JeremySSSSS/tfg-pulpissimo/Documento TFG/titlepage.tex

\thispagestyle{empty}

\begin{center}

Tecnológico de Costa Rica

\par\vspace{1ex}

Escuela de Ingeniería Electrónica

\par\vspace{1ex}

Programa de Licenciatura en Ingeniería Electrónica

\par\vspace{20mm}



\par\vspace*{\fill}

{\large\bf{\scriptTitle}}

\par\vspace*{\fill}

\scriptType

\par\vspace{20mm}

\scriptAuthor

\par\vspace{2ex}

\genderAsesor: \nameAsesor

\par\vspace{2ex}

Campus Tecnológico Local San Carlos

\vspace*{\fill}

\ifdraft{{\today}}{San Carlos, Costa Rica, 2026}

\end{center}
\newpage
\cleardoublepage

%%% Local Variables:
%%% mode: latex
%%% TeX-master: "main"
%%% End:
