JeremySSSSS/tfg-pulpissimo/Documento TFG/acta.tex

%% Acta de Evaluación — remover en versión final

\thispagestyle{empty}

\begin{center}
  \begin{tabular}{c}
    Instituto Tecnológico de Costa Rica \\
    Escuela de Ingeniería Electrónica \\
    Trabajo Final de Graduación \\
    Tribunal Evaluador \\
    Acta de Evaluación
  \end{tabular}
\end{center}

\vfill

\begin{center}
  \begin{tabular}{c}
    Defensa de Proyecto de Graduación \\
    Requisito para optar por el título de Ingeniero en Electrónica \\
    Grado Académico de Licenciatura
  \end{tabular}
\end{center}

\vfill

\begin{center}
  Estudiante:\qquad \textbf{\scriptAuthor}\qquad Carné: \scriptAuthorID

  \vspace*{2ex}

  \setlength\tabcolsep{0pt}
  \begin{tabular}{p{.28\textwidth}p{.70\textwidth}}
    Nombre del proyecto: & \textsl{\scriptTitle}
  \end{tabular}
\end{center}

\vspace{5mm}

\vfill

Los miembros de este Tribunal hacen constar que este proyecto de
graduación ha sido aprobado y cumple con las normas establecidas por
la Escuela de Ingeniería Electrónica del Instituto Tecnológico de
Costa Rica y es merecedor de la siguiente calificación:

\vfill

\begin{center}
  Nota de Proyecto de Graduación: \rule{25mm}{0.5pt}
\end{center}

\vfill

\begin{center}
  Miembros del Tribunal Evaluador
\end{center}

\vfill

\begin{center}
  \begin{tabularx}{\textwidth}{cXc}
    \rule{0.45\textwidth}{0.5pt} && \rule{0.45\textwidth}{0.5pt} \\
    \nameLectorI                 && \nameLectorII \\
    \genderLectorI               && \genderLectorII
  \end{tabularx}

  \vspace{10mm}

  \begin{tabular}{c}
    \rule{0.45\textwidth}{0.5pt} \\
    \nameAsesor \\
    \genderAsesor
  \end{tabular}
\end{center}

\vfill

\begin{center}
  San Carlos, \today
\end{center}

\cleardoublepage

%%% Local Variables:
%%% mode: latex
%%% TeX-master: "main"
%%% End:
