JeremySSSSS/tfg-pulpissimo/Documento TFG/tribunal.tex

%% Acta de Aprobación — remover en versión final

\thispagestyle{empty}

\begin{center}
  \begin{tabular}{c}
    Instituto Tecnológico de Costa Rica \\
    Escuela de Ingeniería Electrónica \\
    Anteproyecto de Trabajo Final de Graduación \\
    Acta de Aprobación
  \end{tabular}
\end{center}

\vfill

\begin{center}
  \begin{tabular}{c}
    Defensa de Proyecto de Graduación \\
    Requisito para optar por el título de Ingeniero en Electrónica \\
    Grado Académico de Licenciatura
  \end{tabular}
\end{center}

\vfill

El Tribunal Evaluador aprueba la defensa del proyecto de graduación
denominado \textsl{\scriptTitle}, realizado por
el señor \scriptAuthor\ y, hace constar que cumple con las normas
establecidas por la Escuela de Ingeniería Electrónica del Instituto
Tecnológico de Costa Rica.

\vfill

\begin{center}
  Miembros del Tribunal Evaluador
\end{center}

\vfill

\begin{center}
  \begin{tabularx}{\textwidth}{cXc}
    \rule{0.45\textwidth}{0.5pt} && \rule{0.45\textwidth}{0.5pt} \\
    \nameLectorI                 && \nameLectorII \\
    \genderLectorI               && \genderLectorII
  \end{tabularx}

  \vspace{10mm}

  \begin{tabular}{c}
    \rule{0.45\textwidth}{0.5pt} \\
    \nameAsesor \\
    \genderAsesor
  \end{tabular}
\end{center}

\vfill

\begin{center}
  San Carlos, \today
\end{center}

\cleardoublepage

%%% Local Variables:
%%% mode: latex
%%% TeX-master: "main"
%%% End:
