JeremySSSSS/tfg-pulpissimo/Documento TFG/fig/schematic_ina240_ads1115.pdf

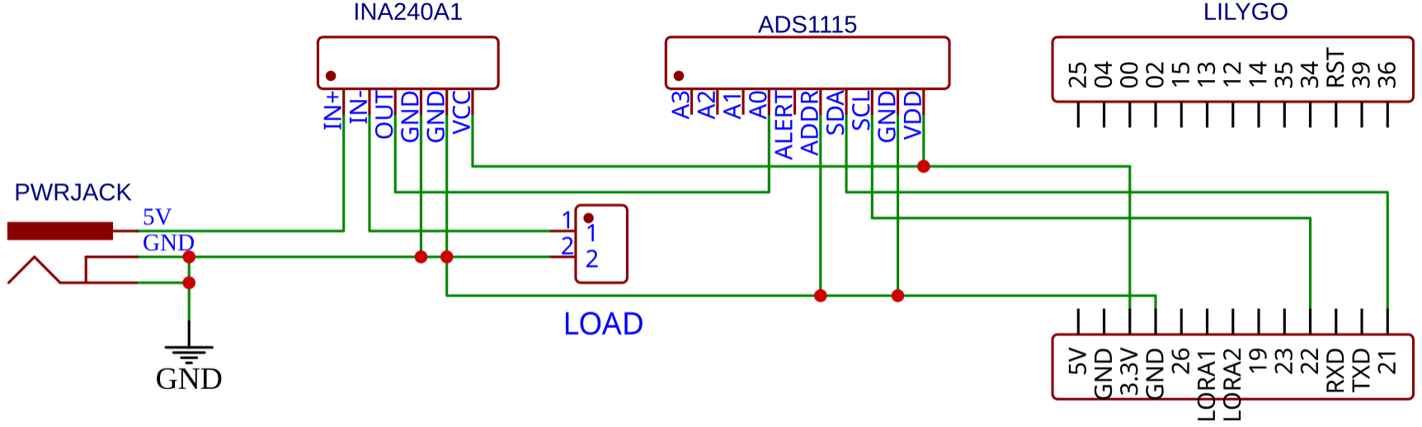
[picture p2: page 1]
