JeremySSSSS/tfg-pulpissimo/Documento TFG/fig/ina240_module.pdf

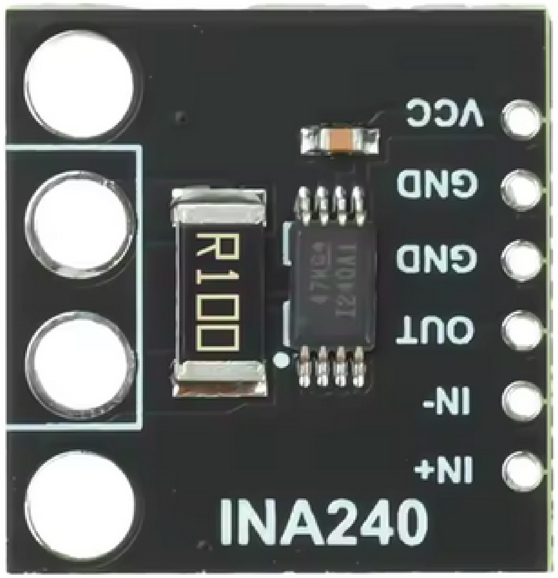
[picture p20: page 1]
