JeremySSSSS/tfg-pulpissimo/Documento TFG/fig/inamp_circuit.pdf

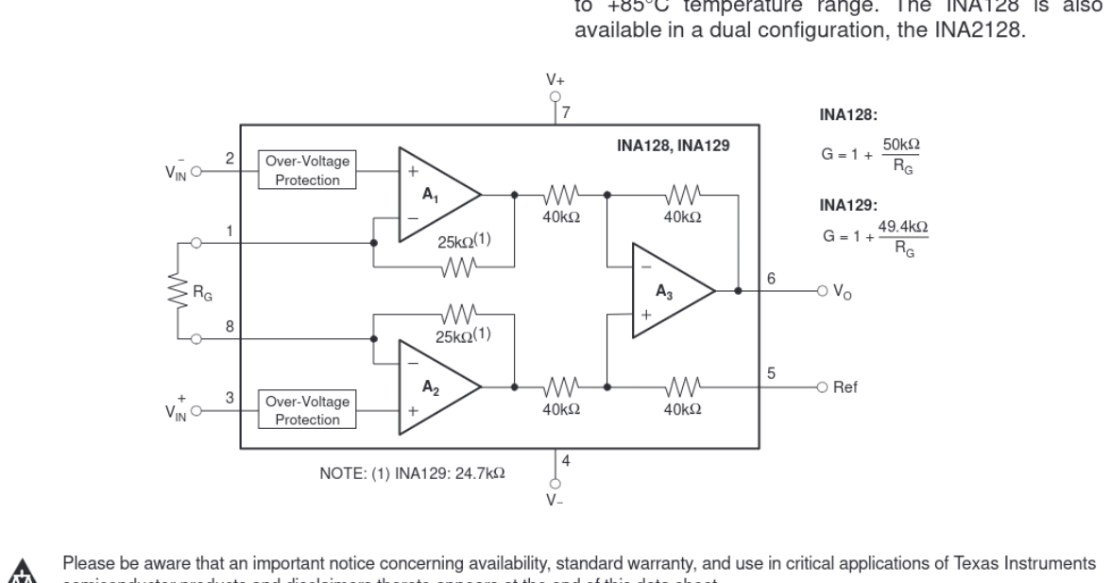
[picture p21: page 1]
