JeremySSSSS/tfg-pulpissimo/Documento TFG/fig/inamp_page1.pdf

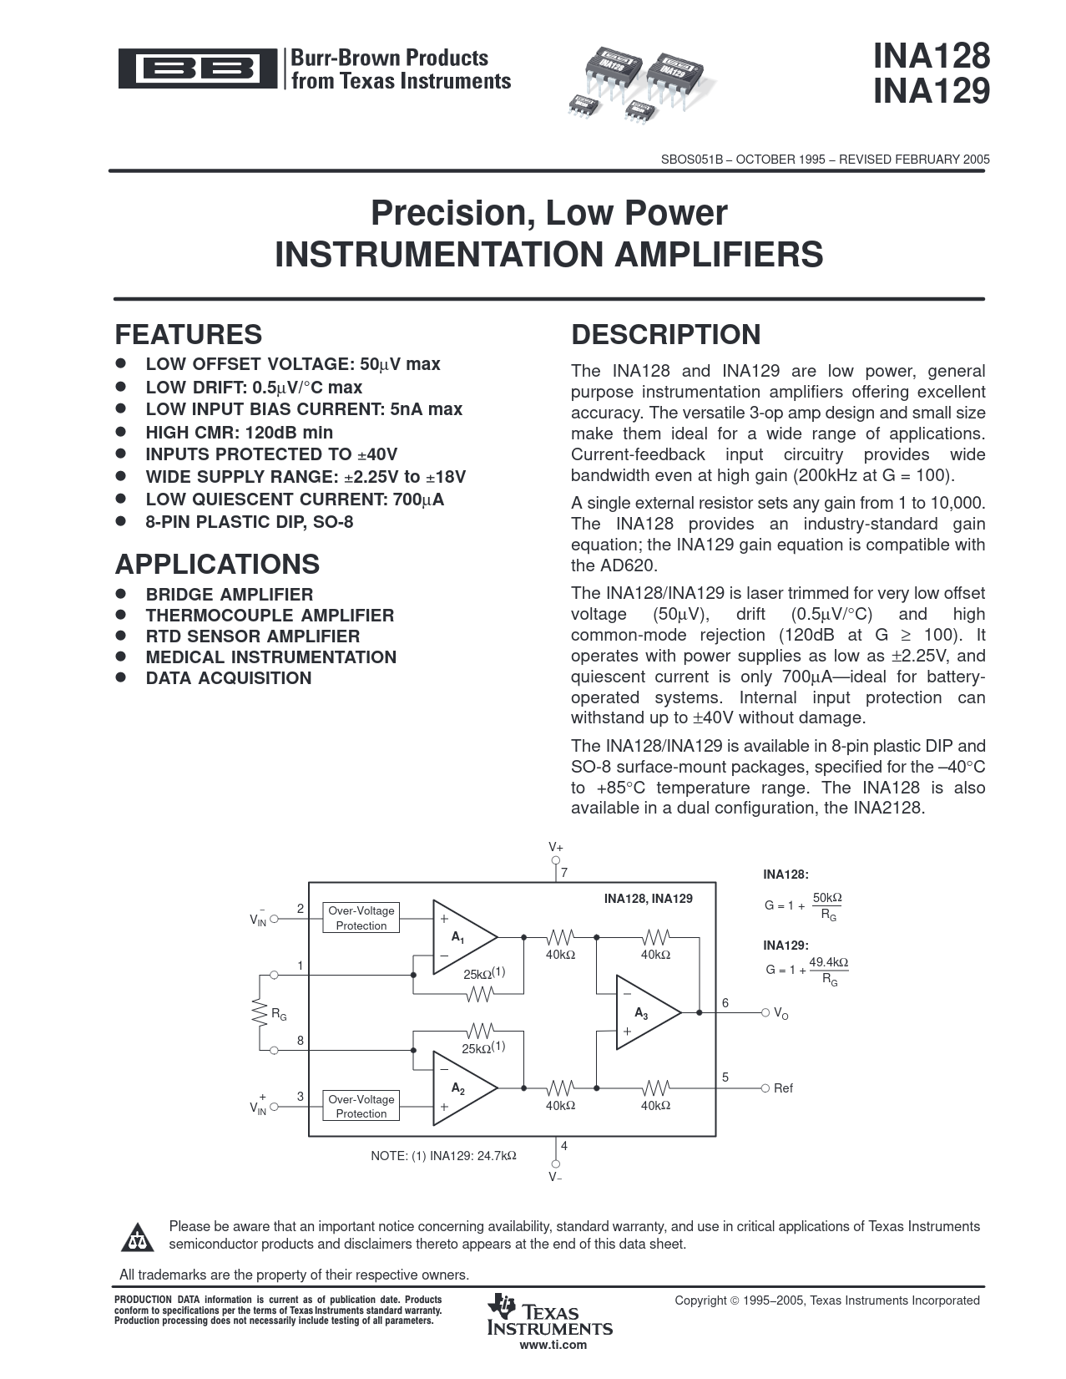
[picture p22: figure]
