JeremySSSSS/tfg-pulpissimo/Documento TFG/fig/ina240_typical_application.png

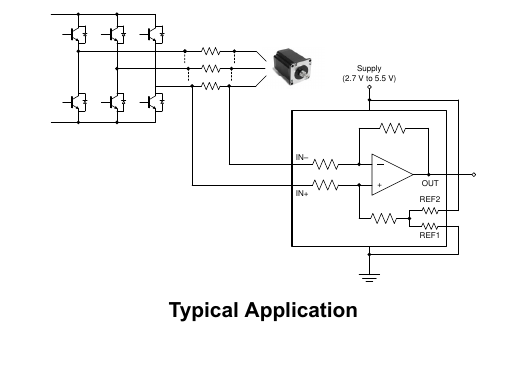
Documento TFG/fig/ina240_typical_application.png
