JeremySSSSS/tfg-pulpissimo/Documento TFG/fig/pcb_ina240_ads1115-1.png

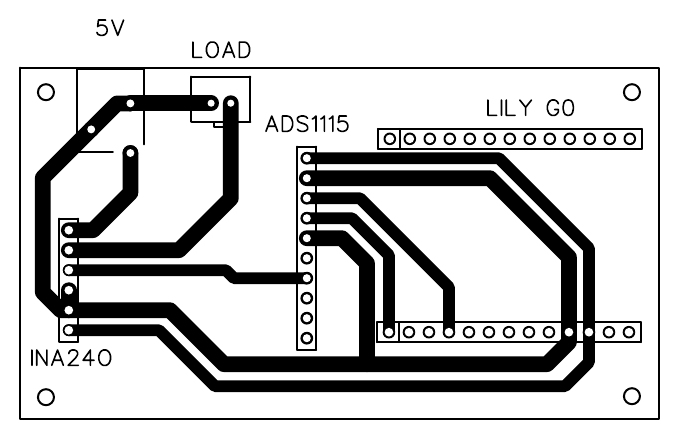
Documento TFG/fig/pcb_ina240_ads1115-1.png
