JeremySSSSS/tfg-pulpissimo/Documento TFG/fig/schematic_ina240_ads1115.png

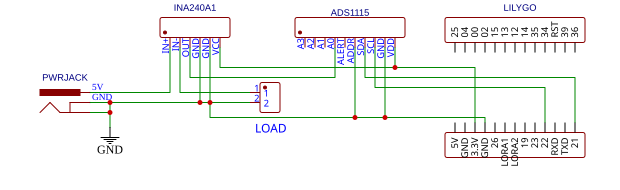
Documento TFG/fig/schematic_ina240_ads1115.png
