JeremySSSSS/tfg-pulpissimo/(list of files, cad)

Other CAD files:
pulpissimo/doc/datasheet/figures_raw/riscv_overview.obj
