JeremySSSSS/tfg-pulpissimo/cv32e40p/firmware/caracterizacion/verificacion.csv

fecha | metodo | programa | T_s | P_med_W | P_pred_W | err_pct | temp_C | n_alu | n_mul | n_mulh | n_div | c_div | n_mem | n_ctrl | n_float | mcycle
2026-07-12 09:25:35 | regresion | bitcount | 93.699 | 1.174457 | 1.174155 | -0.0257 | 40.47 | 517150016 | 0 | 0 | 0 | 0 | 5120004 | 133120001 | 0 | 936990023
2026-07-12 09:26:02 | regresion | bsearch | 12.111 | 1.167593 | 1.16961 | 0.1727 | 40.23 | 60622612 | 0 | 0 | 0 | 0 | 6694406 | 11625412 | 0 | 121113466
2026-07-12 09:31:23 | regresion | conv | 306.634 | 1.165568 | 1.16878 | 0.2756 | 40.72 | 1473186020 | 174592000 | 0 | 0 | 0 | 360096004 | 174592001 | 0 | 3066338027
2026-07-12 09:31:48 | regresion | fixmul | 11.745 | 1.164867 | 1.169049 | 0.359 | 40.6 | 29250017 | 14400000 | 14400000 | 0 | 0 | 4 | 450001 | 0 | 117450020
2026-07-12 09:32:33 | regresion | md5 | 32.088 | 1.169026 | 1.170362 | 0.1142 | 40.6 | 203880020 | 0 | 0 | 0 | 0 | 16320004 | 21120001 | 0 | 320880028
2026-07-12 09:32:54 | regresion | primes | 5.451 | 1.157364 | 1.157617 | 0.0219 | 40.6 | 5081833 | 1411260 | 0 | 1385460 | 42880200 | 4 | 1591141 | 0 | 54506480
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
