JeremySSSSS/tfg-pulpissimo/cv32e40p/firmware/caracterizacion/archivo/2026-07-12_pre_corrida_limpia/verificacion.csv

fecha | metodo | programa | T_s | P_med_W | P_pred_W | err_pct | n_alu | n_mul | n_mulh | n_div | c_div | n_mem | n_ctrl | n_float | mcycle
2026-06-18 16:45:09 | chopper | sha256 | 39.004 | 0.011575 | 9.251665 | 79827.9914 | 310380609 | 0 | 0 | 0 | 0 | 34650090 | 13370064 | 0 | 390040952
2026-06-18 16:45:54 | chopper | md5 | 30.696 | 0.012660 | 9.248301 | 72951.3480 | 170280175 | 5760000 | 0 | 0 | 0 | 23520044 | 36360016 | 0 | 306960285
2026-06-18 16:49:20 | chopper | sha256 | 39.004 | 0.005807 | 9.251665 | 159219.1838 | 310380609 | 0 | 0 | 0 | 0 | 34650090 | 13370064 | 0 | 390040952
2026-06-18 16:52:17 | chopper | sha256 | 39.004 | 5.087820 | 9.251665 | 81.8395 | 310380609 | 0 | 0 | 0 | 0 | 34650090 | 13370064 | 0 | 390040952
2026-06-18 16:55:08 | chopper | sha256 | 39.004 | 9.259173 | 9.251665 | -0.0811 | 310380609 | 0 | 0 | 0 | 0 | 34650090 | 13370064 | 0 | 390040952
2026-06-18 16:55:53 | chopper | md5 | 30.696 | 9.260119 | 9.248301 | -0.1276 | 170280175 | 5760000 | 0 | 0 | 0 | 23520044 | 36360016 | 0 | 306960285
2026-06-18 16:57:21 | chopper | floyd | 74.701 | 9.256475 | 9.244476 | -0.1296 | 220848909 | 800 | 0 | 980800 | 27463200 | 105686500 | 97335511 | 0 | 747006340
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
