JeremySSSSS/tfg-pulpissimo/Documento TFG/figuras/setup_medicion.pdf

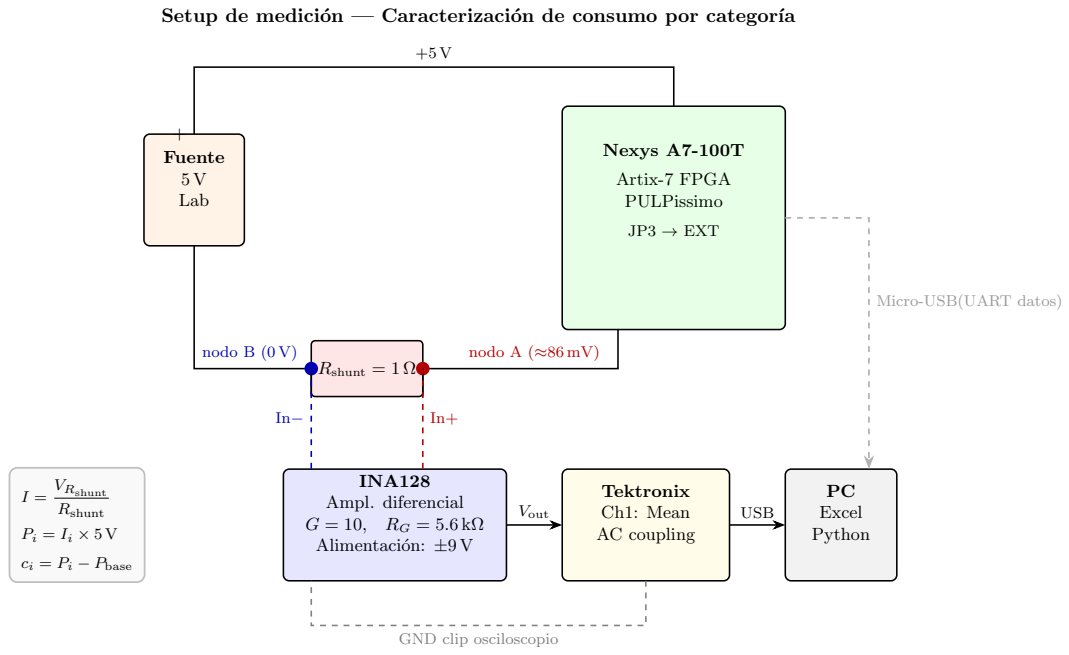
[picture p38: page 1]
Fuente 5 V Lab; Nexys A7-100T; Artix-7 FPGA PULPissimo; JP3 → EXT; Rshunt = 1 Ω; INA128 Ampl. diferencial G = 10, RG = 5.6 kΩ Alimentaci´on: ±9 V; Tektronix Ch1: Mean AC coupling; PC Excel Python; nodo B (0 V); nodo A (≈86 mV); Vout; USB; VRshunt; Rshunt

Setup de medici´on — Caracterizaci´on de consumo por categor´ıa

Micro-USB(UART datos)

ci = Pi − Pbase

GND clip osciloscopio
