JeremySSSSS/tfg-pulpissimo/Documento TFG/fig/diagrama_3_1_arquitectura_general.pdf

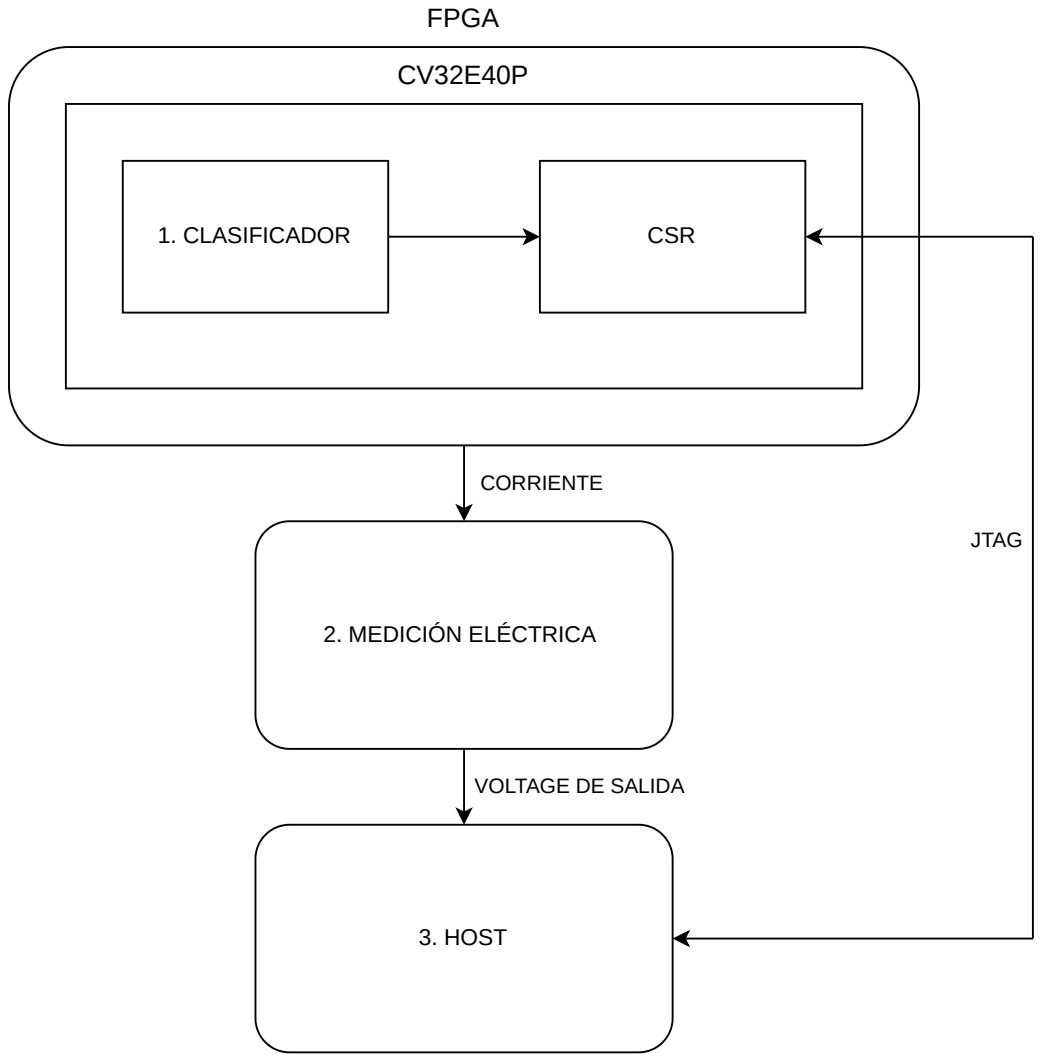
[picture p39: page 1]
CORRIENTE; 1. CLASIFICADOR; CSR; 2. MEDICIÓN ELÉCTRICA; 3. HOST; JTAG; FPGA

VOLTAGE DE SALIDA
