JeremySSSSS/tfg-pulpissimo/Documento TFG/fig/diagrama_3_3_shunt_alimentacion.pdf

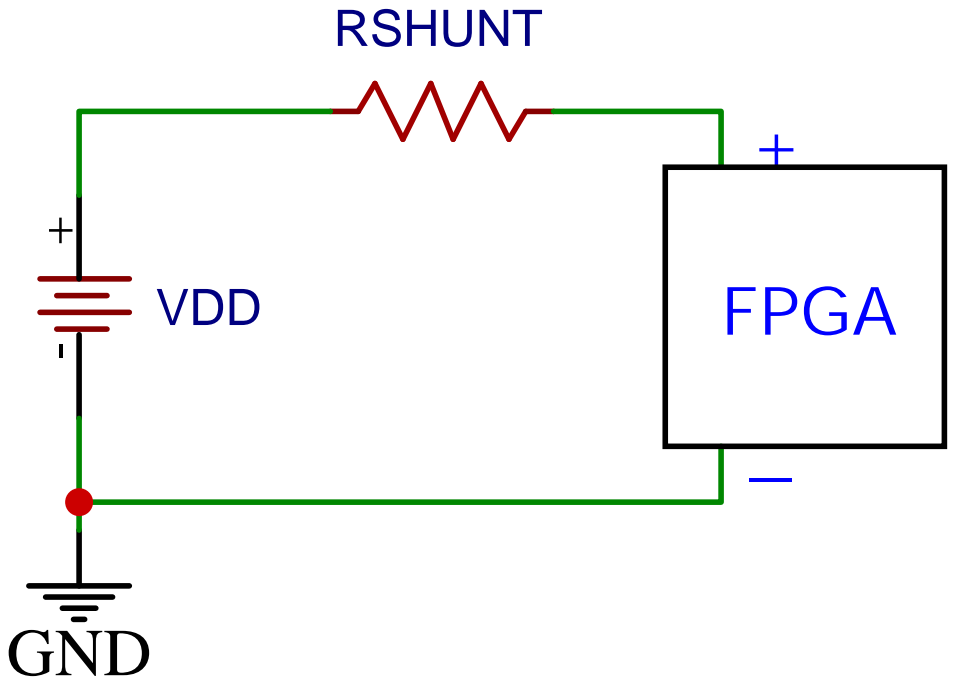
[picture p40: page 1]
