JeremySSSSS/tfg-pulpissimo/Documento TFG/fig/diagrama_3_4_cadena_adquisicion.pdf

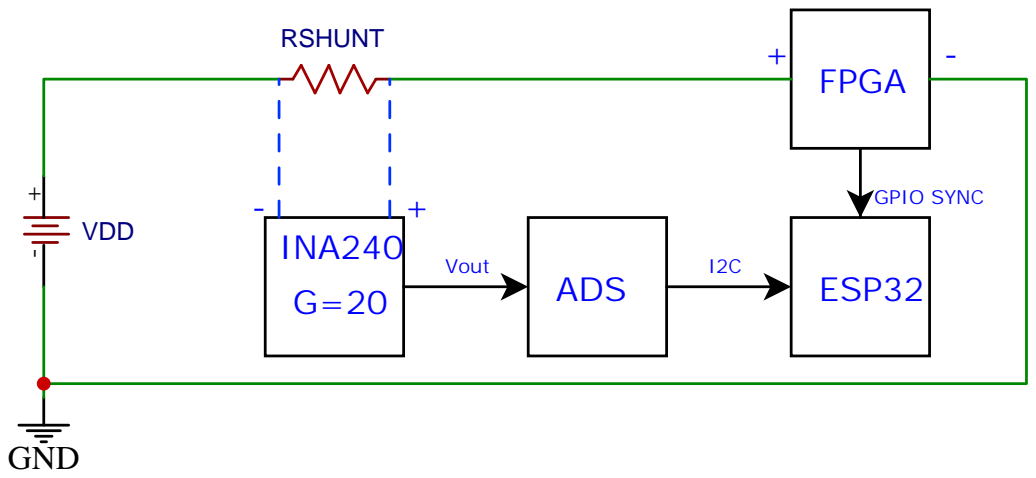
[picture p41: page 1]

A | A
B | B
C | C
D | D

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
TITLE:
Sheet_2 | REV: 1.0
Date: | 2026-06-06

Sheet: 1/1
Drawn By: jeremysotoch

Company: Your Company
