JeremySSSSS/tfg-pulpissimo/Documento TFG/fig/diagrama_3_5_integracion_clasificador.pdf

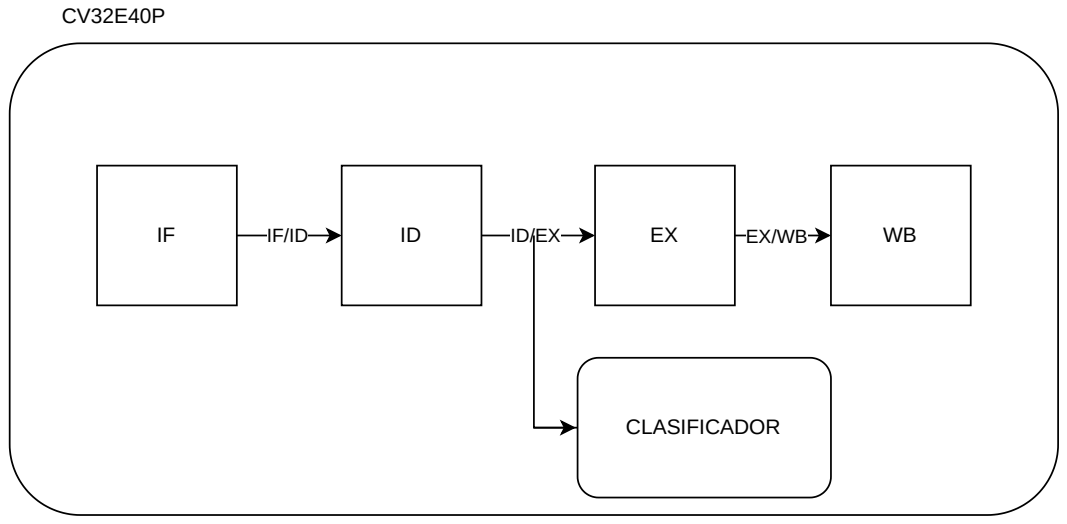
[picture p42: page 1]
CLASIFICADOR
