JeremySSSSS/tfg-pulpissimo/Documento TFG/fig/diagrama_3_6_cadena_jtag.pdf

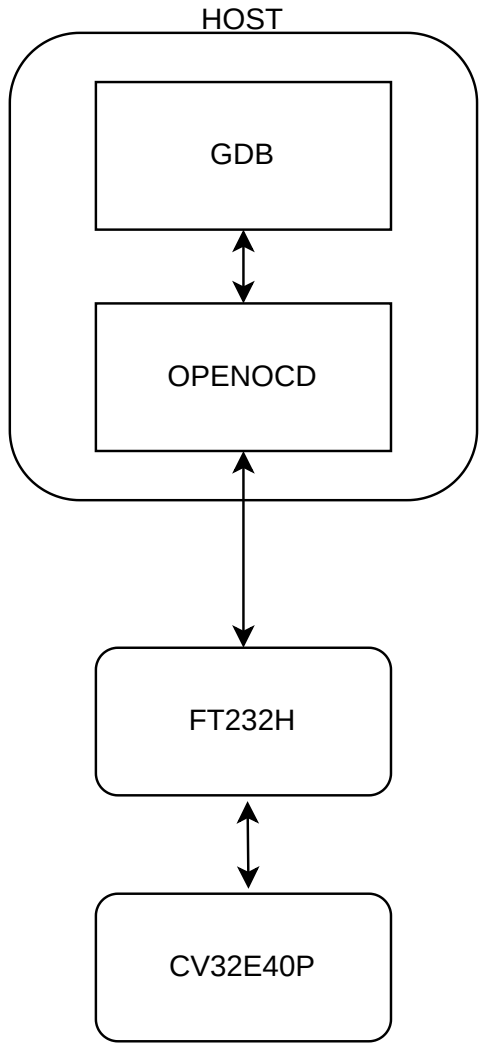
[picture p43: page 1]
GDB; OPENOCD; HOST
