JeremySSSSS/tfg-pulpissimo/Documento TFG/fig/pcb_ina240_ads1115.pdf

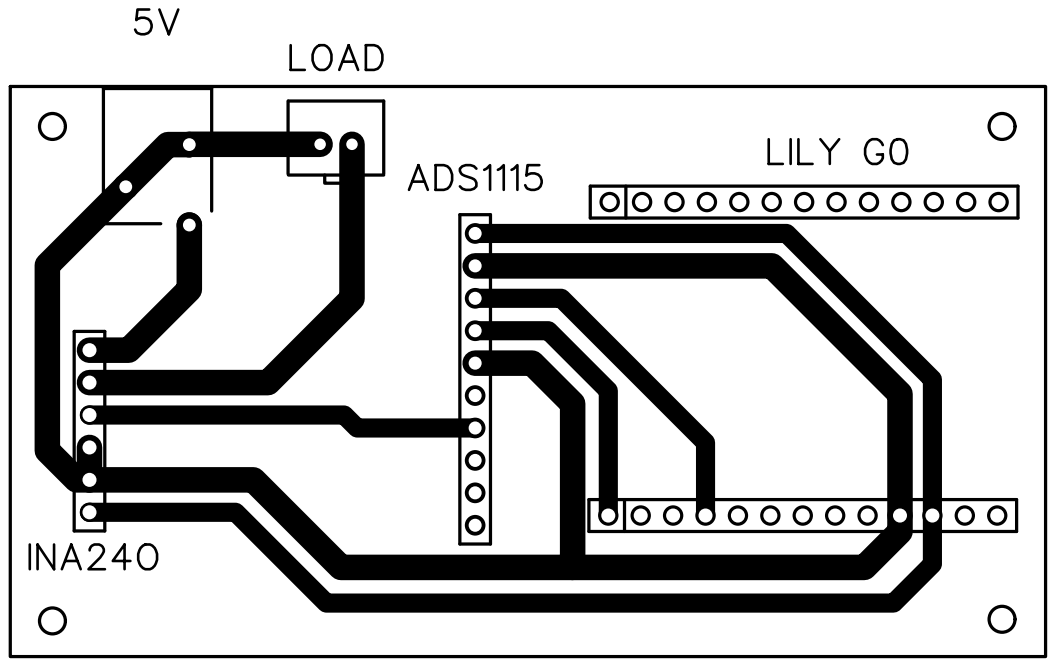
[picture p44: page 1]
