JeremySSSSS/tfg-pulpissimo/Documento TFG/fig/TEC.pdf

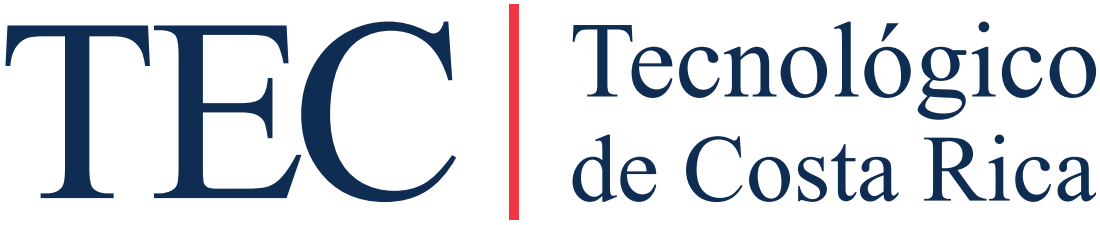
[picture p45: page 1]
