JeremySSSSS/tfg-pulpissimo/(list of files, drawings)

Other design files:
Circuito de Potencia/PCB_New-Project123-copy_2026-06-21.pcbdoc
