JeremySSSSS/tfg-pulpissimo/(commit log)

2026-06-12 Base: PULPissimo (pulp-platform/pulpissimo @ bfc3d9a) + CV32E40P (pulp-platform/cv32e40p @ 7a49867)
    Árbol upstream sin modificar de ambos proyectos como punto de partida del TFG.
    - pulpissimo/: SoC, targets FPGA (Nexys A7), flujo Bender/Vivado
    - cv32e40p/: core RISC-V RV32IMC, base del clasificador de instrucciones
    [riscv_overview.obj]
2026-06-12 cv32e40p: clasificador de instrucciones por categoría (CSR 0xBC0-0xBCB)
    Módulo cv32e40p_insn_classifier.sv: clasifica cada instrucción retirada en
    6 categorías (arith, logic, memory, branch, jump, float) con contadores de
    64 bits expuestos como 12 CSR custom en pares LO/HI (0xBC0-0xBCB).
    - cv32e40p_pkg.sv: direcciones de los 12 CSR
    - cv32e40p_core.sv: instancia del clasificador + mux de lectura CSR
    - cv32e40p_decoder.sv: acepta los CSR custom sin illegal instruction
    - Filtro csr_access para no contaminar el conteo con los propios csrr/csrw
    - Manifiestos (Bender.yml, flist, src_files.yml) actualizados
2026-06-12 pulpissimo: plataforma FPGA Nexys A7-100T para medición de consumo
    - xilinx_pulpissimo.v: puerto pad_esp32_sync (io_08, antes led0_o) como
    pulso de sincronización hacia la ESP32; fix pad_jtag_tdo input->inout
    (impedía el enganche de OpenOCD)
    - nexys4DDR.xdc: pad_esp32_sync -> H4 (PMOD JD1); constraints de
    temporización JTAG (create_clock TCK, clock groups asíncronos, max_delay
    en CDC del dmi_jtag)
    - openocd-ft232h.cfg: configuración OpenOCD para adaptador FT232H
    - run_batch.tcl: síntesis no incremental (fix Synth 8-6885), limpieza de
    pads no usados post-síntesis, BIN_FILE true
2026-06-12 cv32e40p: firmware de caracterización por categoría
    - firmware/dominated_loops/: bucles dominados (~97%) por categoría
    (arith, logic, memory, branch, jump, float), ventana de medición por
    GPIO8 -> GPIO26 (ESP32), fin con ebreak
    - frequency_probe.S: verificación de la frecuencia real del core (10 MHz)
    - csr_test/: test mínimo de los contadores vía JTAG/GDB (COMANDOS_JTAG.md)
2026-06-12 pulpissimo: bitstreams Nexys A7-100T
    - xilinx_pulpissimo_12csr.bit: bitstream actual con los 12 CSR del
    clasificador y el fix de JTAG TDO
    - xilinx_pulpissimo_jtagfix_20260604.bit: bitstream previo (fix JTAG TDO,
    2026-06-04), conservado como referencia
2026-06-12 Documentación de los cambios del TFG (CAMBIOS_TFG.md)
2026-06-12 Agrega README: descripción del proyecto y resumen de cambios
2026-06-12 Corrige clasificación del rango CSR 0xBC0-0xBCB: machine custom RW, no user
    Según la convención de direcciones del privileged spec RISC-V, en 0xBC0
    los bits [9:8]=11 indican nivel máquina y [11:10]=10 read/write.
2026-06-12 Agrega documento escrito del TFG (fuentes LaTeX + PDF compilado)
    - tfg_doc/: capítulos .tex, referencias.bib, figuras (fig/), estilos y
    main.pdf compilado (47 páginas); .gitignore para artefactos de LaTeX
    - DOCS/: diagramas CV32E40P y PULPissimo referenciados por marco_teo.tex
    vía ../DOCS/, de modo que el documento compila desde el repo
2026-06-12 Renombra tfg_doc/ a Anteproyecto/ y completa DOCS/ con el material de referencia
    - Anteproyecto/: mismo contenido (la ruta relativa ../DOCS/ sigue resolviendo)
    - DOCS/: datasheets, papers, esquemáticos y PCB del medidor high-side,
    manuales de referencia y figuras (88 archivos)
2026-06-12 Agrega Documento TFG/: plantilla del informe final (tesis)
    Derivada del anteproyecto con la estructura del informe final:
    - implementacion.tex: esqueleto con la sección nueva de categorías por
    firma de energía (esquema confirmado para la tesis) y TODOs por sección
    - resultados.tex: verificación funcional, caracterización M1/M2,
    validación contra la hipótesis del 10% y discusión
    - conclusiones.tex: conclusiones por OE y trabajo futuro
    - main.tex: scriptType de informe final; solucion/experimento/cronograma
    fuera del compilado como material de referencia
    - intro/resumen/objetivos con notas de conversión a voz ejecutada
2026-06-12 Agrega carpetas Circuito de Potencia/ y TTGO LORA32/ (vacías, con .gitkeep)
2026-06-12 README: agrega las carpetas nuevas a la tabla de estructura
2026-06-12 TTGO LORA32: documentación y sketches de la LilyGO TTGO LoRa32
    - README.md: guía de programación de la placa
    - hola_oled.ino: prueba de OLED SSD1306
    - ads1115_read/: lectura del ADS1115 por I2C
    - gpio19_test/, gpio26_test/: pruebas de GPIO (sync con la FPGA)
2026-06-12 cv32e40p: testbenches XSim de verificación del clasificador
    Simulaciones usadas para validar el clasificador antes de FPGA:
    - custom/category_counter_*.{c,S}: tests de contadores (simple, asm,
    all_types, regression, demo y freeze — este último validó el filtro
    de accesos CSR con conteos exactos vs conteo manual)
    - custom/category_loop_*.S: bucles por categoría para simulación
    - run_category_*_xsim.sh + xsim_category_simple_gui.tcl: flujo XSim
    Desarrolladas originalmente sobre el árbol cv32e40p_direct; pueden
    requerir ajustes de ruta para correr contra este árbol.
2026-06-12 Especificación del clasificador v2: categorías por unidad activa
    Documento de diseño previo a la implementación: 7 contadores
    (ALU simple / mul / mulh / div / mem / control / float), mapa de señales
    verificado en el RTL con referencias archivo:línea, mapa de 14 CSR
    (0xBC0-0xBCD), cambios de RTL requeridos, riesgos abiertos (FPU, MAC32
    compartido) y plan de verificación con modelo dorado.
2026-06-12 Diseño v2: sección de manejo de instrucciones multiciclo
    Mecánica (retire pulsa 1 vez por instrucción), absorción de la latencia
    en el coeficiente, tabla de varianza intra-categoría, acotación de e_div
    con operandos min/max/aleatorios y justificación de descartar el conteo
    por ciclos.
2026-06-12 Diseño v2: adopta modelo híbrido (opción B) con contador de ciclos DIV_CYC
    - 8.º contador DIV_CYC (0xBCE/0xBCF): acumula ciclos de ocupación del
    divisor; sin señales nuevas (los regs ID/EX retienen el operador
    durante el stall, id_stage:1472-1573)
    - Modelo: E = sum(e_i*n_i) en las 6 categorías de latencia fija +
    p_div*c_div para división
    - Nota: las burbujas cargan alu_en=1/ALU_SLTU (id_stage:1593-1597) — no
    contaminan, pero descartan generalizar el conteo por ciclos
    - Verificación de c_div con divisiones de operandos conocidos
2026-06-12 cv32e40p: clasificador v2 — categorías por unidad activa (16 CSR)
    Implementa DISENO_CLASIFICADOR_V2.md:
    - cv32e40p_insn_classifier.sv: 7 contadores de instrucciones (ALU simple
    +branch-not-taken, MUL, MULH, DIV, MEM, CTRL=jump+branch-taken, FLOAT)
    + DIV_CYC (ciclos de ocupación del divisor). Resolución de branches
    un ciclo después vía branch_q1; filtros csr_access y system
    - cv32e40p_pkg.sv: 16 CSR 0xBC0-0xBCF
    - cv32e40p_decoder.sv: acepta los 16 CSR
    - cv32e40p_id_stage.sv: evento nuevo mhpmevent_system (mret/uret/dret/
    wfi/fence) flopeado junto a los demás
    - cv32e40p_core.sv: cablea mult_operator_ex, mhpmevent_branch_taken y
    mhpmevent_system al clasificador
    Sintaxis verif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
2026-06-12 cv32e40p: suite de verificación del clasificador v2 con modelo dorado
    - clasif_smoke.c: test dirigido en un solo bloque asm (región medida sin
    instrucciones del compilador): 7 categorías, branches taken/not-taken,
    instrucción anulada por flush, filtros csr/system, DIV con operandos
    variados
    - golden_clasif.py: parsea el trace del tracer, detecta la ventana medida
    decodificando el hex (16.º reset → primera lectura), clasifica por
    mnemónico, branch tomado por PC no-fall-through, e invariante
    - run_clasif_v2_xsim.sh: compila firmware + RTL de este árbol con tracer
    (UVM), corre XSim y valida contra el golden
    Primer PASS (XSim 2022.1): alu=12 mul=5 mulh=7 div=6 mem=8 ctrl=5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
2026-06-12 cv32e40p: ignora artefactos de XSim de la suite clasif_v2
2026-06-12 Diseño v2: uso de DIV en el modelo (columna c_div en regresión, e_div efectivo)
2026-06-12 Suite clasif_v2: modo GUI opcional (GUI=1) para inspeccionar ondas en XSim
2026-06-12 Suite clasif_v2: documenta el modo GUI en el README
2026-06-12 Limpieza v1: elimina scripts/tests de simulación viejos, csr_test y bitstream superado
    - run_category_*.sh + xsim_category_simple_gui.tcl (sustituidos por
    run_clasif_v2_xsim.sh con modelo dorado)
    - custom/category_*.{c,S} (tests v1 con conteo manual)
    - csr_test/ (mapeo viejo 0xBC0-0xBC5, documentado como desactualizado)
    - bitstream jtagfix_20260604 (superado por el 12csr)
    Se conservan: dominated_loops (base del firmware v2), bitstream 12csr
    (el grabado actualmente en la FPGA) y CAMBIOS_TFG.md (histórico del
    anteproyecto). README actualizado a v2 (16 CSR, modelo híbrido, suite).
2026-06-12 Suite clasif_v2: parada automática en la región medida para el modo GUI
    waves_clasif.tcl agrega las señales del clasificador y detiene la
    simulación al final de la región medida (condición sobre registros
    div=6 && mem=8 && ctrl=5), imprimiendo los 8 contadores. Validado en
    batch: para con alu=12 mul=5 mulh=7 div=6 mem=8 ctrl=5 float=0
    divcyc=150.
    Gotchas de add_condition (XSim 2022.1) documentados en el README:
    literales en binario, sin -label, glitches en señales combinacionales,
    X en t=0.
2026-06-12 Suite clasif_v2: GUI manual con breakpoint simple (revierte la automatización)
    break_clasif.tcl solo arma el breakpoint (div=6 && mem=8 && ctrl=5) que
    pausa la sim al final de la región medida; las ondas y el run los maneja
    el usuario como siempre. Validado: pausa en t=4960 ns con alu=12 y
    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
2026-06-12 Suite clasif_v2: modo GUI con wfi (el truco del freeze test viejo)
    En GUI el firmware se compila con -DWAVES_HOLD: tras leer los CSR ejecuta
    wfi + lazo de seguridad (patrón de category_counter_freeze.c). El core se
    duerme y los contadores quedan congelados en sus valores finales — se
    leen en cualquier punto del tramo final del waveform, sin breakpoints ni
    TCL. Validado: al final de la sim (t=200 us) los 8 contadores muestran
    12/5/7/6/8/5/0/150 exactos. Se elimina break_clasif.tcl.
2026-06-12 Suite clasif_v2: guarda la configuración de ondas del usuario y la carga en modo GUI
    tb_top_clasif.wcfg (selección/layout de señales del GUI) versionada; el
    script la pasa con --view si existe, para no rearmar las ondas cada vez.
2026-06-12 Suite clasif_v2: bucles dominados por categoría (7) simulables con golden
    - loop_main.c: harness común (reset en un bloque, llamada, lectura,
    printf/wfi); loop_{alu,mul,mulh,div,mem,ctrl,float}.S: 64 instrucciones
    objetivo + control por iteración, .option norvc
    - run script: modos LOOP=, DIVOPS=min|max, ITERS=, SKIPRTL=1
    - golden: mnemónicos comprimidos normalizados (el tracer imprime c.bne,
    c.jal...) y pseudoinstrucciones (bnez, j, ret)
    Resultados (ITERS=8, 6 bucles enteros PASS contra el golden):
    dominancias 95-98 %; ensayo de constancia de p_div con DIV_CYC
    ciclo-exacto en los tres casos: min=4.0, rnd=23.0, max=34.0 ciclos/div
    (rango 8.5x — la justificación medida del modelo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
2026-06-13 Diseño v2 §9: caracterización potencia→energía (CPI) y referencias
    Documenta la metodología de banco para extraer e_i: potencia != energía,
    evidencia del v1 (arith midió más potencia que float por IPC≈0.34 vs 0.97),
    corrección e_i = ΔP·T/N con T de mcycle, los dos métodos (dominados/regresión)
    y referencias (Tiwari, Hennessy&Patterson/CPI, Isci&Martonosi, Contreras, Bircher).
2026-06-13 Bitstream v2 (16 CSR): clasificador por unidad activa para Nexys A7
    Síntesis con el clasificador v2 (7 categorías + DIVCYC, CSR 0xBC0-0xBCF).
    Timing cerrado (WNS +1.596 ns, WHS +0.050 ns, 0 errores). Convive con el v1
    xilinx_pulpissimo_12csr.bit como referencia.
2026-06-14 Caracterización energética v2: firmware físico + regresión (Método 2)
    Suite de medición en FPGA para el clasificador de 16 CSR:
    - Bucles dominados por categoría (M1) y cargas reales con mezcla natural
    (sort/matmul/crc/strings/gcd/fir) para la regresión (M2).
    - Harness con ventana GPIO8 + volcado de los 16 CSR y mcycle a results.
    - regresion.py: resuelve E = N·e por mínimos cuadrados (div con c_div,
    modelo híbrido), reporta R² y número de condición.
    Resultado (9 ejecuciones, 10 MHz): 7 categorías caracterizadas,
    R²=0.9995, condición 31.7, error ±5%. e_div modelado por p_div=480 nJ/ciclo.
    [runs.csv]
2026-06-15 M1: calibracion definitiva por bucles dominados (firmware/metodo1)
    Directorio limpio del Metodo 1, un .S autocontenido por categoria
    (alu/mul/mulh/div/mem/ctrl/float/idle) calibrados a ~5 min/categoria.
    Incluye:
    - mix1/mix2/mix3: programas de validacion con las 7 categorias mezcladas
    - pipeline captura+repeticiones (run_method1, run_and_log, fetch_sheet)
    - regresion/validacion (regresion.py, validate_m1.py, probar.py)
    - datos medidos (runs_m1.csv 5min, runs_m1_32s.csv)
    Coeficientes definitivos con CV<0.01%, estables en 13/32/300 s (+/-0.35%),
    validados held-out con 7 categorias a <1.3% de error en potencia.
    [runs_m1.csv, runs_m1_32s.csv]
2026-06-15 M1: desenrollado, benchmarks reales y modelo corregido estatica/dinamica
    - Bucles dominados desenrollados a 256 instr/iter (vs 64): el overhead de
    control (addi/bnez) pasa de 1-en-64 a 1-en-256 -> inflacion in-sample de los
    coeficientes cae ~4x (peor caso mul 4.52% -> 1.16%). LOOP_COUNT /4 mantiene
    ~5 min y mismo n_X. Calibracion 64-instr respaldada en runs_m1_unroll64.csv.
    - Programas reales (benchmarks) via harness.S + kernel C: aes (crypto, entero),
    dijkstra (grafos, entero). nbody descartado (cadenas seriales FP cuelgan este
    bitstream, como fir/dotprod).
    - probar.py: modelo A (E=sum e_i*n_i) vs modelo B corregido
    (E=P_idle*T + sum e_din_i*n_i, T de mcycle).
    Hallazgo central: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
    [runs_m1.csv, runs_m1_unroll64.csv]
2026-06-19 Add characterization flow
    [chopper_results_sesion1.csv, coeficientes.csv, cpi_categorias.csv, datos.csv, verificacion.csv]
2026-06-22 Add files via upload
    PCB V1
    [PCB_New-Project123-copy_2026-06-21.pcbdoc]
2026-06-22 XADC temperatura on-chip + fixes de medicion + reorg caracterizacion
    RTL (integracion XADC del Artix-7 para medir temperatura del die):
    - xadc_temp.v: primitivo XADC + FSM DRP (reset de arranque + reintento)
    - pulpissimo.sv: inyecta la temp en s_gpio_in_temp[30:19] (sin tocar pads)
    - xilinx_pulpissimo.v: instancia el XADC y la rutea a GPIO io_19..30
    - run_batch.tcl / run.tcl: agregan xadc_temp.v a la sintesis
    Firmware/caracterizacion:
    - comun/jtag.py: detector de corrida LIMPIA (descarta inflacion por JTAG) +
    lectura de temperatura del die por JTAG (ultima_temp_cC)
    - benchmarks/harness.S: guarda mcycle_ini en MEMORIA (kernels asm pisaban s1)
    - comun/pulp_temp.h: lectura de temperatura del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
    [coeficientes.csv, cpi_categorias.csv, datos.csv, pidle_temp.csv, pidle_temp_mezclado_1928.csv, verificacion.csv]
2026-06-22 Bitstream con XADC (temperatura del die) integrado
    xilinx_pulpissimo_xadc.bit: bitstream del Nexys A7-100T con el sensor de
    temperatura del XADC integrado (lectura por GPIO io_19..30). Validado en HW
    (38.87 C, coincide con Vivado SYSMON). Sintetizado desde el RTL del commit
    anterior (xadc_temp.v + pulpissimo.sv + xilinx_pulpissimo.v).
2026-07-05 clasif_v2: archivo de resultados divcyc vs operandos (4.0/23.0/34.0 c/div, golden PASS)
    [chopper_results_sesion1.csv, coeficientes.csv, cpi_categorias.csv, datos.csv]
2026-07-05 caracterizacion: estructura final de dos metodos (bucles + regresion)
    caracterizar.py unificado para ambos metodos, verificar.py actualizado,
    benchmarks de validacion completos en ensamblador (wl_bsearch, wl_fixmul,
    wl_fpalu, wl_fpctrl, wl_fpmem, wl_ycbcr corregido) y datos de la campana
    preliminar. Ignora locks de LibreOffice y texput.log.
    [coeficientes.csv, datos.csv, pidle_temp.csv]
2026-07-05 sim: testbench actualizado y configuracion de ondas del clasificador
2026-07-05 archivo: iteraciones previas de caracterizacion (chopper, metodos v1-v3)
    Se conservan como historial; la version vigente es firmware/caracterizacion.
    [captures.csv, chopper_historico.csv, chopper_results.csv, chopper_results_sesion1.csv, coeficientes.csv, coeficientes_m1.csv, comparacion.csv, cpi_categorias.csv]
2026-07-05 notas: avances para reuniones
2026-07-08 bucles M1: ventanas ~20s y bucle ctrl representativo
    Bucles reescalados de ~5min a ~20s (INA228 no necesita ventanas largas).
    ctrl.S redisenado: branches condicionales siempre tomados con operandos
    cambiantes, distancias variadas, jal y victimas que se buscan y descartan
    (el 'j .+4' anterior era el caso degenerado y subestimaba 2.6x el costo
    real: 2.08 -> 5.41 nJ, convergiendo con la regresion). Los operandos se
    inicializan DESPUES de gpio_high (el macro pisa t0/t1). idle.S con guarda
    IDLE_REPS para variantes cortas. Datos y coeficientes de la campana.
    [coeficientes.csv, datos.csv, datos_legacy_20260705_2100.csv]
2026-07-08 regresion M2: set de calibracion desacoplado (15 programas)
    Nuevos wl_mulhscale.c (mulh SIN mul, verificado en opcodes: rompe la
    colinealidad que daba mul negativo) y wl_radix.c (div/rem con divisor
    variable, 4to programa de division con perfil mem). div converge con M1
    (0.425 vs 0.410 nJ/ciclo); mul positivo; cond 6.8.
    [coeficientes.csv, datos.csv]
2026-07-08 esp32: firmware oficial del banco INA228 (ventana unica) + sonda
    esp32_ina228: reemplaza al chopper (ADS1115+INA240). ADCRANGE=1
    (78.125 nV), promedia dentro de la ventana GPIO19, publica p_avg (+n,
    duracion y temp_ina del DIETEMP para atribucion de deriva) al Sheet con
    4 reintentos y backoff. sync_probe: diagnostico del pin de ventana en
    vivo (con guardas LoRa: GPIO19 es MISO del SX127x).
2026-07-08 scripts: robustez de campana y correccion termica en verificacion
    - timeout de p_avg REINTENTA la medida (jtag, caracterizar, sweep) en vez
    de abortar; corridas parciales de bucles fusionan coeficientes.
    - verificar.py: linea base P_idle(T) = P_idle_ref + b*(T_die - T_ref)
    corregida por corrida con el XADC (default --pidle temp; medir/archivo/
    valor como alternativas). La pendiente b sale del barrido termico
    FORZADO (aire solo al FPGA): b=1.99 mW/C, R2=0.975, n=60 (pidle_fit.csv).
    - sweep_termico: guarda el ajuste, descarta transitorios >3 sigma.
    - jtag.leer_temp(): temperatura del die sin ejecutar programa.
    - Validacion M2 con base de 24h + correccion: sesgo +0.02% bajo 4.7 C de
    e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
    [pidle_fit.csv, pidle_temp.csv, verificacion.csv]
2026-07-08 scripts: una corrida por medida y timeout de P_avg 180s -> 30s
    Auditoria previa: en ~140 corridas desde el 6-jul ningun programa vario su
    mcycle entre corridas ni entre dias (las 3 aparentes variaciones son
    versiones distintas del binario) -> la doble corrida de confirmacion de
    run_one_limpio sobra. run_medido() la reemplaza: una corrida, con las
    guardas gratis (reintento si mcycle corrupto IPC>1.02 o si la fila del
    ESP32 no llega). get_pavg 180->30s; el timeout ahora dispara reintento de
    la medida, no espera muerta. Campanas ~2x mas rapidas.
    [verificacion.csv]
2026-07-08 datos: campana final 8-jul (coeficientes M1/M2 y validacion) + idle regresion 20s
    M1: P_idle 1.1583 @ 43.92C; M2: n=15, R2=0.9955, cond=6.3. Validacion 8
    cargas enteras por metodo: |eps| 0.12%/0.23%. Makefile regresion: idle
    acortado a 67 reps (~20 s; el default de 1000 duraba 5 min).
    [coeficientes.csv, datos.csv, verificacion.csv]
2026-07-11 bucles: operandos VARIADOS en mulh/mul/mem/float (diseno pool de 45 pares)
    Auditoria: la brecha M1->M2 correlaciona con la staticidad de operandos
    (alu variado +13%, float 4 pares fijos +25%, mem dato unico +51%, mulh
    multiciclo +110%). Los bucles con operandos fijos miden la cota inferior
    del costo (sin conmutacion de datos). Rediseno comun: pool de 10 registros
    con valores variados -> 45 pares distintos por bloque, resultados a
    sumidero (sin colapso), 2 updates/iter, dominancia dinamica ~98%,
    init post-gpio_high. div se deja (per-cycle, convergido 7% con M2).
2026-07-11 datos: recaracterizacion 11-jul con bucles de operandos variados + validacion
    mulh/mul/mem/float x3 reps (dominancia 97.6-98.9%, rangos 0.1-0.6 mW,
    ciclos/op segun diseno). Validacion 8 enteras: |eps|=0.090%, sesgo
    -0.003%, fixmul -0.04%.
    [coeficientes.csv, datos.csv, verificacion.csv]
2026-07-11 regresion: modelo diferencial NNLS opcional (--modelo diferencial, estilo EfiMon)
    Separa intensidad de composicion: delta = alfa*r_total + sum extras*r_k con
    NNLS (>=0). alfa = costo base por instruccion retirada (modo comun que antes
    se volcaba en alu); extras = sobrecostos por categoria. Con los datos del
    8-jul: alfa=2.175 nJ (~= alu aislado de M1, 2.24: confirmacion cruzada) y
    el sesgo de validacion de M2 baja de +0.225% a +0.146%. Se guarda como
    coeficientes absolutos + fila div_n (costo base de la instr de division);
    modelo.potencia_dinamica evalua div_n si existe (retrocompatible).
2026-07-11 regresion: barrido de intensidad estilo EfiMon (--modelo efimon)
    Replica el barrido de utilizacion de EfiMon via ciclo de trabajo: el
    harness (modo CHUNKS) corre el kernel en 10 tandas con wfi intercalado ->
    misma composicion, intensidad 100/60/30%. duty_variants.mk GENERADO con
    REPS/SLEEP_TICKS calculados de los mcycles medidos (ventanas ~20 s las
    45). ajustar_efimon: NNLS CON INTERCEPTO sobre potencia total, idle como
    fila ancla (P_static = intercepto, ec. 5 de EfiMon). Recuperacion validada
    con datos sinteticos (intercepto exacto, coefs +-2%). El barrido
    decorrelaciona el modo comun por diseno experimental, no por formula.
2026-07-11 duty: fix REPS por tanda (x10 de trabajo) y tiempo de pared para las tasas
    Bug 1: cada variante compilaba con el REPS total pero el harness llama al
    kernel CHUNKS veces -> 10x el trabajo previsto. Ahora REPS = por tanda.
    Bug 2 (conceptual): mcycle se congela en wfi, asi que T=mcycle/f es solo
    tiempo ACTIVO y las tasas n/T no bajaban con la intensidad (el barrido no
    barria). medir_uno ajusta T = activo/duty para *_d60/_d30 (exacto por
    construccion; el P_med del ESP32 ya promedia la ventana completa).
    Detectado por el usuario en las primeras 3 ventanas de la campana.
    [datos.csv]
2026-07-12 fact-check del marco contra las fuentes primarias locales
    Verificado contra los PDF de DOCS/: (1) EfiMon/CARLA corregidos — el 4.4%
    es de EfiMon (AMD) y son DESVIACIONES compartido-vs-aislado, no error
    contra medicion; CARLA reporta 1.9% CPU / 9.7% GPU y no es 'extension
    sobre AMD'. Corregido en marco, en la justificacion del umbral de la
    hipotesis (objetivos) y en el TODO de la Discusion. (2) Jimenez: SI hizo
    mediciones electricas (V/I de fuente, para el overhead de 6 mW del PMU);
    la afirmacion 'ni realizar mediciones electricas' era falsa — ahora
    precisa que se limitan al costo del monitor, sin coeficientes de energia
    por instruccion; ademas su FPGA es el MISMO dispositivo (XC7A100T),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
    [datos.csv]
2026-07-12 datos: campana efimon 11-jul (46 ventanas con barrido) + validacion + header CSV honesto
    Intercepto 1.1465 W (= recta termica a 0.3 mW; idle medido 5.4 mW alto).
    Validacion 8 enteras: |eps|=0.131%, max 0.287%, sesgo +0.025% (clasico:
    +0.225%). Sublinealidad potencia-intensidad observada (la Fig. 3 de EfiMon
    reproducida en la plataforma). Encabezado de coeficientes.csv ahora
    declara el modelo usado.
    [coeficientes.csv, datos.csv, verificacion.csv]
2026-07-12 pares diferenciales: e_ctrl y e_mulh por resta de variantes identicas
    Tercer camino independiente para las dos discrepancias abiertas del
    contraste. ctrl: lazo enrollado vs desenrollado x8 (mismos conteos de todo
    salvo saltos tomados 8:1, addi del contador igualados). mulh: bloques
    identicos con/sin 16 mulh intercalados en computo entero. pares.py mide
    idle + 4 ventanas (~2 min) y despeja e=(dE)/(dn), comparando contra M1/M2.
    Conteos por iteracion verificados en el desensamblado.
2026-07-12 contraste: pares diferenciales como arbitro medido de ctrl y mulh
    metodologia sec:contraste: la tecnica (variantes identicas salvo la
    categoria; e = dE/dn, todo lo comun se cancela). resultados: veredicto
    medido — e_ctrl=7.6 nJ (M1 −27%, M2 +18%) y e_mulh=6.5 nJ (M1 −10%, M2
    confirmado corto como decia fixmul) — con la precaucion de no trasplantar
    los valores de referencia a los juegos calibrados (compensacion interna).
    [pares.csv]
2026-07-12 efimon: pares diferenciales al set de calibracion
    Los pares (ctrl 8:1, mulh con/sin) entran como programas de calibracion a
    intensidad plena: inyectan variacion de-un-factor-a-la-vez que ancla la
    atribucion de las categorias en disputa hacia sus valores medidos, sin
    trasplantes manuales. find_elf busca tambien en pares/elf.
2026-07-12 M2 oficial restaurado (efimon-45); pares-en-set degradado a opt-in
    Resultado negativo documentado: incluir los pares en la calibracion sube
    alu de 1.83 a 2.34 (sus nucleos sinteticos densos no comparten el costo
    del alu de codigo compilado) y sesga la validacion +0.27%. Ni el anclaje
    duro de ctrl/mulh lo corrige (probado offline con WLS p5/p20 y fix).
    Hallazgo positivo: los coeficientes efimon-45 de la sesion anterior
    validaron en la sesion de hoy con sesgo -0.033% (robustez entre sesiones).
    coeficientes.csv restaurado de d30a08e; --pares queda experimental.
    [datos.csv, verificacion.csv]
2026-07-12 resultados: tabla del barrido por ciclo de trabajo + hallazgo test-retest de M2
    tab:barrido_m2 (15 programas x 3 intensidades, delta sobre P_static):
    escalado ~proporcional al duty con la sublinealidad señalada. Repeticion
    completa de la campana: el ajuste se reproduce (R2 0.982) pero la
    atribucion por categoria NO (mulh x2.8, div +55% entre campanas del mismo
    dia; soporte alto <=13%) -> la regresion determina la combinacion, no los
    coeficientes debiles: juego oficial = el validado; el contraste por
    categoria descansa en M1 y los pares diferenciales. Incluye PCB del banco
    movida a solucion 4.4 con configuracion final del INA228 (ADCRANGE=1,
    calculo en firmware, sin SHUNT_CAL) y apendice aju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
    [coeficientes.csv, datos.csv, verificacion.csv]
2026-07-12 regresion: coeficientes oficiales (efimon-45 validados) restaurados tras el test-retest
    [coeficientes.csv]
2026-07-12 GUI web local (gui.py) para caracterizar/verificar + script de reproducibilidad entre campanas
2026-07-12 gui: un solo lazo de sondeo del log (dos en paralelo duplicaban lineas)
2026-07-12 gui: N campanas M2 en secuencia (cola de tandas; 2+ con --no-build, aborta si una falla)
2026-07-12 salida legible en caracterizar/reproducibilidad: progreso con ETA, delta sobre idle, coefs en nJ con soporte, residuos ordenados; fix --refit (usaba TODO el historico mezclado y sin correccion de dut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
    [jtag.py, sheet.py]
2026-07-12 corrida limpia: datos historicos archivados (se conserva el barrido termico); GUI solo efimon, sin re-ajuste ni panel de analisis, campanas multiples en M1 y M2; respaldo automatico de coeficientes p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
    [bucles_coeficientes.csv, bucles_datos.csv, datos_legacy_20260705_2100.csv, pares.csv, pidle_temp_mezclado_1928.csv, regresion_coeficientes.csv, regresion_datos.csv, verificacion.csv]
2026-07-12 ETA por clase de corrida (idle/100/60/30%): el promedio simple mentia porque _d30 tarda ~3x
2026-07-12 gui: 'campana i/N' en vez de 'tanda' (mismo termino que el documento)
2026-07-12 verificar: cada tanda de validacion en su propio archivo validaciones/validacion_<metodo>_<ts>.csv (ademas del historico), como campanas/ de los coeficientes
2026-07-12 reproducibilidad: M1 tambien particiona campanas por fila idle (campanas consecutivas se fusionaban con el gap temporal)
2026-07-12 verificar: modo de linea base (temp/medir/archivo) en el nombre del archivo de tanda
2026-07-13 verificar: retirar modo 'temp' (correccion termica que sobre-corregia); --pidle default 'archivo', 'medir' opt-in para medir la base en sesion
2026-07-13 reproducibilidad m1: rechazo de transitorio de arranque en frio en la linea base (ventana idle >2mW sobre la mediana); reproduce los coeficientes del documento
2026-07-13 cargas de validacion: sustituir md5/logistic/fpctrl (redundantes) por wmul (mulh dom), divsum (div dom) y mixed (balanceada); mejora cobertura de mulh/div y rompe dominancia de alu
2026-07-13 gui: quitar modo 'temp' del selector de linea base (default 'medir', queda 'archivo'); coherente con verificar.py
2026-07-13 plan anti-error: kernels de calibracion mulhchain (mulh ~25% sin mul, C compilado) y saxpy (float+mem region fpgain); DEFAULT_PROGS 17; guarda de duracion en get_pavg (filas ESP32 desalineadas); --re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
    [coeficientes.csv, coeficientes_20260711_225824.csv, coeficientes_20260711_234051.csv, coeficientes_20260712_001519.csv, coeficientes_20260712_004951.csv, coeficientes_20260712_012438.csv, coeficientes_20260712_063835.csv, coeficientes_20260712_065305.csv]
2026-07-13 saxpy: reestructurado al patron probado de vecscale (un fcvt por iteracion; dos fcvt adyacentes por vuelta colgaban la FPU del bitstream, modo de falla conocido); B[] se llena una vez, REPS 230k
2026-07-14 retirar saxpy de la calibracion (no termina en este bitstream ni con el patron de vecscale; falla de FPU conocida); set queda en 16 programas con mulhchain
2026-07-14 gui: mulhchain en la lista M2 (16 programas)
2026-07-14 revertir mulhchain: coeficientes oficiales restaurados (campana 5 del 12-jul); experimento documentado en los fuentes — fija mulh (estable en 3.9) pero su alu denso contamina la atribucion y la valid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
    [coeficientes_20260713_194633.csv, datos.csv, validacion_regresion_medir_20260713_195000.csv, verificacion.csv]
2026-07-15 secretos fuera del repo: credenciales WiFi y URL del Apps Script a secrets.h/config_local.py (locales, no versionados) con plantillas .example; preparacion para publicar
2026-07-15 README por directorio y limpieza para publicación
    README raíz actualizado al clasificador v2 y al banco INA228; README
    personalizados en cv32e40p, pulpissimo y cada subdirectorio del banco de
    caracterización; eliminado CSV duplicado.
    [verificacion (Copy).csv]
2026-07-15 README raiz: quitar filas de bitacoras y especificacion de la tabla
2026-07-15 borrar bitacoras, especificacion v2 e iteraciones previas de caracterizacion
    Fuera del arbol: CAMBIOS_TFG.md, AVANCES_REU.md, DISENO_CLASIFICADOR_V2.md
    y los directorios de firmware archivados (chopper, dominated_loops*,
    linear_regression*, metodo1*, metodo2). Referencias actualizadas.
    [captures.csv, chopper_historico.csv, chopper_results.csv, chopper_results_sesion1.csv, coeficientes.csv, coeficientes_m1.csv, comparacion.csv, cpi_categorias.csv]
2026-07-15 README: corregir comandos de caracterizar.py (subcomandos, --modelo efimon) y detalles
2026-07-15 esp32: no bloquear el arranque esperando WiFi (perdia la 1.ra ventana tras reset) + LED integrado ON al medir
    [validacion_regresion_medir_20260715_124857.csv]
2026-07-18 gui: campanas de validacion (N tandas de verificar en secuencia)
2026-07-18 benchmarks: 6 cargas de validacion REALES en C (aes128, dijkstra, dct8x8, rle, sieve, qsort) + separadas de las oficiales en el gui
    Algoritmos completos compilados por GCC sin ajustar la mezcla de
    instrucciones, pedidos por el profesor. Enteras (sin FPU), REPS para
    ventanas de ~15-35 s a 10 MHz. En el gui aparecen en su propio grupo,
    desmarcadas por defecto.
    [validacion_bucles_medir_20260715_135417.csv, validacion_regresion_medir_20260715_125227.csv, validacion_regresion_medir_20260715_125534.csv, validacion_regresion_medir_20260715_125642.csv, validacion_regresion_medir_20260717_205553.csv, verificacion.csv]
2026-07-18 benchmarks: 3 cargas reales mas para cubrir div y float (pctstats, reloj, gray)
    pctstats: divisiones de divisor variable (estadisticas por ventanas);
    reloj: divisiones por constantes que este GCC emite como divu reales;
    gray: RGB->luminancia en float con el patron seguro de la FPU
    (-ffp-contract=off, sin fmadd). mulh real queda cubierto por dct8x8.
    [validacion_regresion_medir_20260717_220947.csv, verificacion.csv]
2026-07-18 benchmarks: conjunto real ahora son kernels de BEEBS sin modificar
    10 kernels (mont64, ud, jfdctint, nettleaes, dijkstra, huffbench,
    levenshtein, ns, aqsort, fqsort) con fuentes intactas en beebs/ (GPL,
    LICENSE incluida) + beebs_wrap.c que adapta su interfaz al harness y
    provee stubs de libc. Cobertura verificada: mulh en mont64, div en
    ud/huffbench/jfdctint/nettleaes, float en fqsort (solo comparaciones
    fle/flt, el unico patron FP seguro de la suite) y gray propia como
    respaldo. Reemplazan a las 8 cargas C propias anteriores.
2026-07-18 benchmarks: retirar fqsort (comparaciones FP densas cuelgan la FPU, 3.er patron)
2026-07-18 benchmarks: perlin (stb_perlin de BEEBS) como candidato float EXPERIMENTAL
    Solo fadd/fmul/fsub/fcvt/feq + tablas (sin fdiv/fsqrt/fmadd, verificado
    por desensamblado); floor() de math.h resuelto con stub en el wrapper.
    Cadenas de lerps mas profundas que gray: probar en HW con corrida corta.
2026-07-18 benchmarks: la validacion pasa a ser SOLO kernels de BEEBS (+gray float propia)
    Conjunto oficial .S retirado del build (fuentes conservadas); perlin
    retirado (colgo en HW: cadenas de lerps dependientes; con fqsort, ningun
    kernel float de BEEBS es ejecutable en este bitstream); GUI con un solo
    grupo de cargas, todas marcadas por defecto.
    [validacion_regresion_medir_20260718_111830.csv, validacion_regresion_medir_20260718_112027.csv, verificacion.csv]
2026-07-18 benchmarks: REPS calibrados con las duraciones medidas (tanda 18-jul) + ns sin DCE
    ns: -fno-ipa-pure-const (GCC eliminaba foo() entera: ventana de 9 ms y
    error de 1,2% que era puro ruido de 2 muestras del INA228). Todos los
    demas BEEBS predijeron con <0,3% ya en la primera tanda.
    [validacion_regresion_medir_20260718_113908.csv, validacion_regresion_medir_20260718_114520.csv, verificacion.csv]
2026-07-18 benchmarks/harness: limpiar .bss al arrancar (los kernels BEEBS asumen estaticas en cero)
    .bss es NOLOAD: el JTAG no lo reescribe y la SRAM solo nace en cero con
    el bitstream. Por eso la primera tanda tras un reset funcionaba y la
    segunda se colgaba en dijkstra (su pool de memoria arrancaba con la
    basura del programa anterior). La limpieza corre antes de gpio_high:
    fuera de la ventana de medicion.
    [validacion_bucles_medir_20260718_123303.csv, validacion_bucles_medir_20260718_124008.csv, validacion_regresion_medir_20260718_115012.csv, validacion_regresion_medir_20260718_115021.csv, validacion_regresion_medir_20260718_115034.csv, validacion_regresion_medir_20260718_115156.csv, validacion_regresion_medir_20260718_115249.csv, validacion_regresion_medir_20260718_115404.csv]
2026-07-18 benchmarks: dijkstra -> strsearch (stringsearch1 de BEEBS)
    dijkstra retirado por cuelgues intermitentes de su qmalloc sobre pool
    estatico; strsearch (Boyer-Moore-Horspool, MiBench/BEEBS) cubre el mismo
    perfil mem+ctrl sin reservador de memoria. abort() stub en el wrapper.
    [validacion_regresion_medir_20260718_124637.csv, validacion_regresion_medir_20260718_125252.csv, validacion_regresion_medir_20260718_130009.csv, verificacion.csv]
